flirn/strombluete/stl/kegel.stl

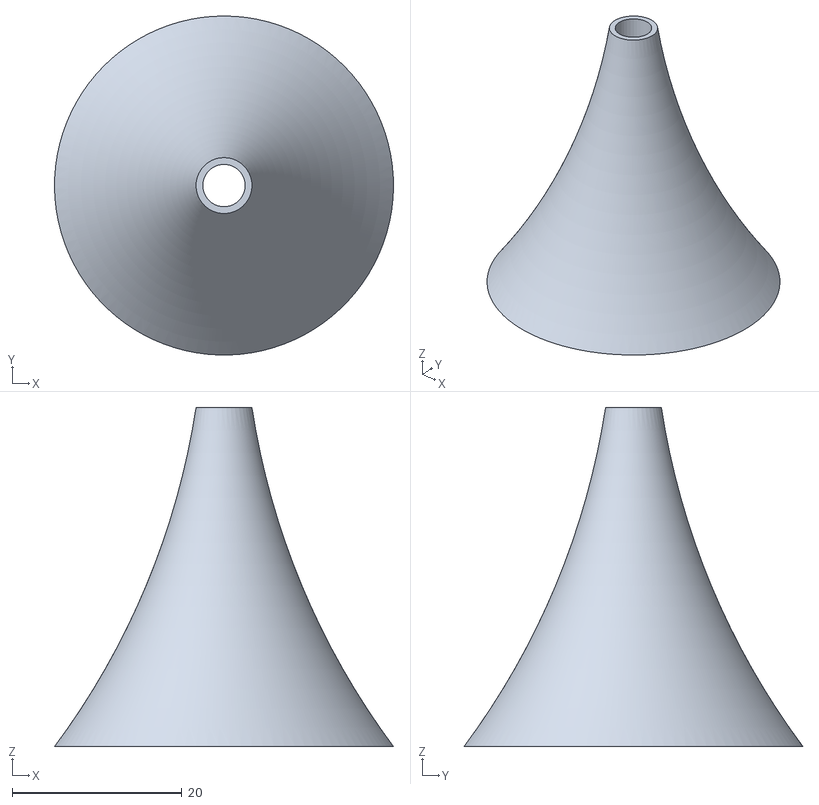
[picture p8: CAD file, 2023-10-23]
stl/kegel.stl
40.0 x 40.0 x 40.0
