flirn/strombluete/stl/kopfUnten.stl

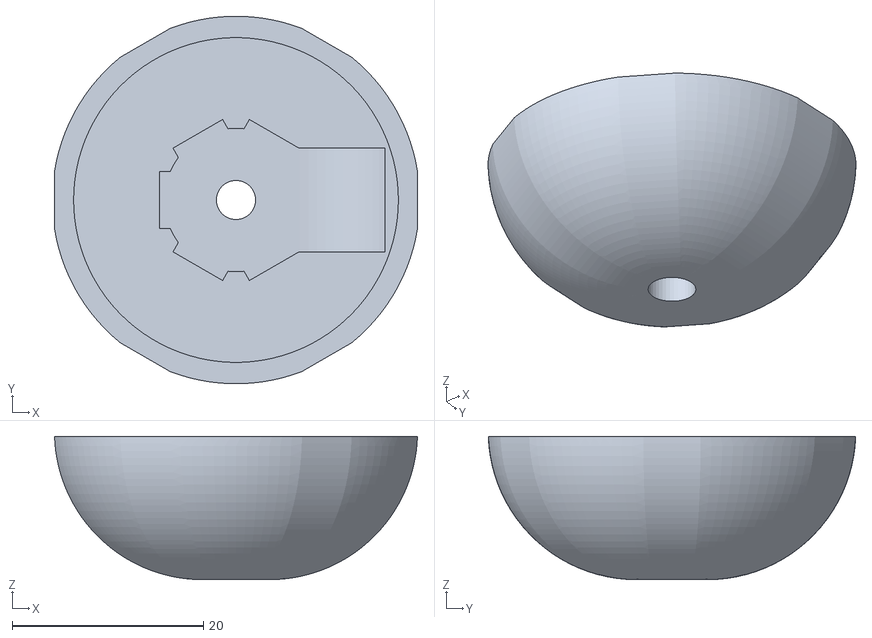
[picture p9: CAD file, 2023-10-23]
stl/kopfUnten.stl
38.0 x 38.5 x 15.0
