flirn/strombluete/stl/bluetenblatt.stl

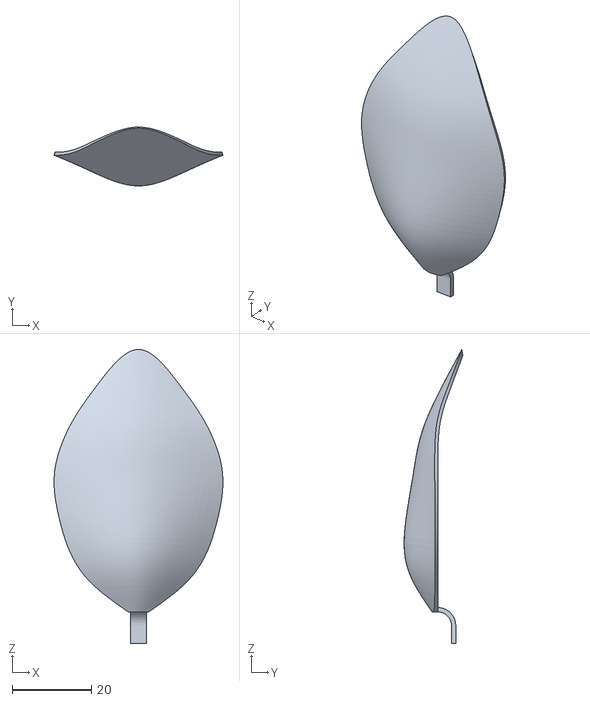
[picture p10: CAD file, 2023-10-23]
stl/bluetenblatt.stl
42.5 x 14.8 x 74.0
