flirn/strombluete/stl/kopfOben.stl

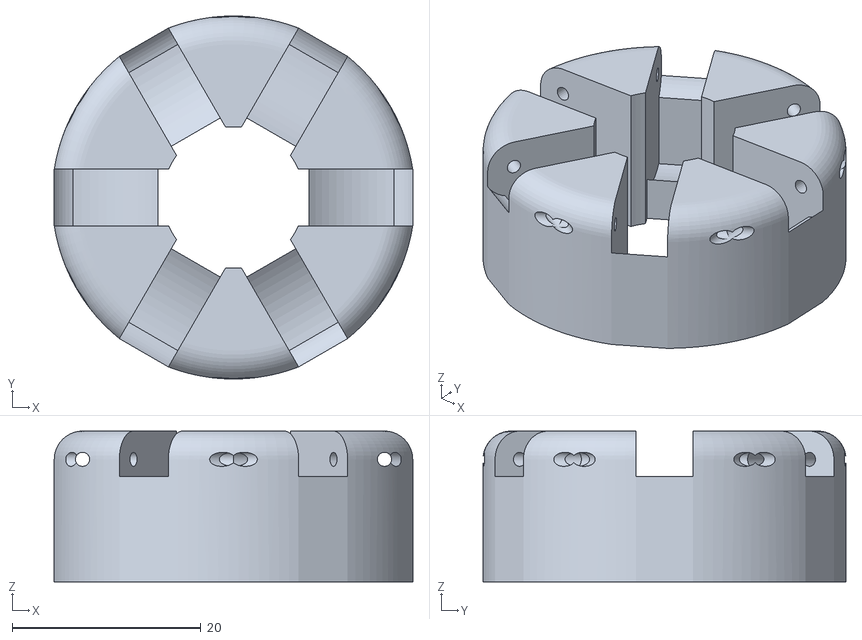
[picture p11: CAD file, 2023-10-23]
stl/kopfOben.stl
38.0 x 38.5 x 16.0
