flirn/strombluete/stl/zahnrad.stl

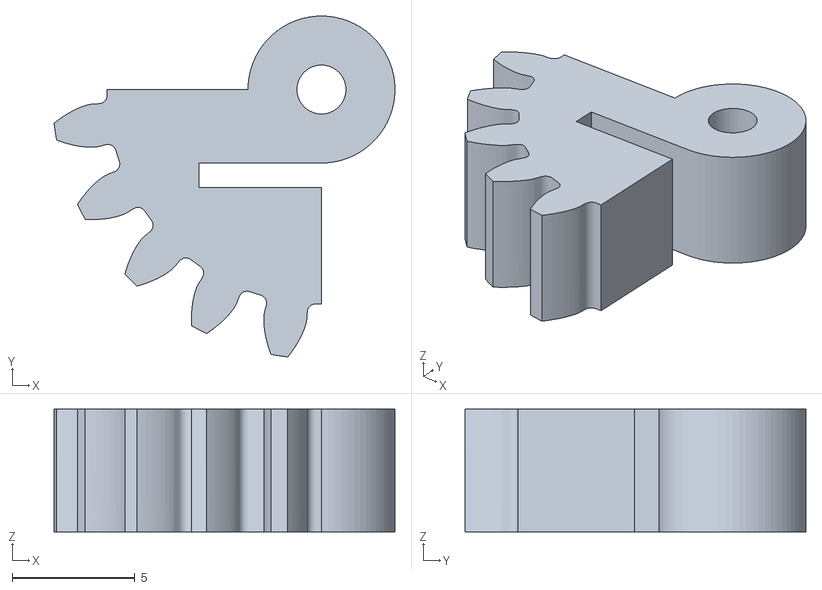
[picture p12: CAD file, 2023-10-23]
stl/zahnrad.stl
13.9 x 13.9 x 5.00
