flirn/strombluete/stl/deckel.stl

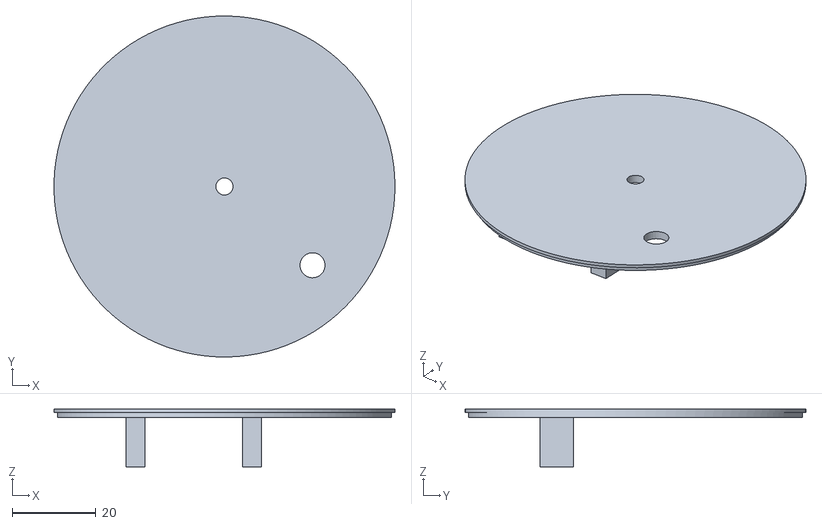
[picture p13: CAD file, 2023-10-23]
stl/deckel.stl
81.6 x 81.6 x 13.8
