flirn/strombluete/stl/basis.stl

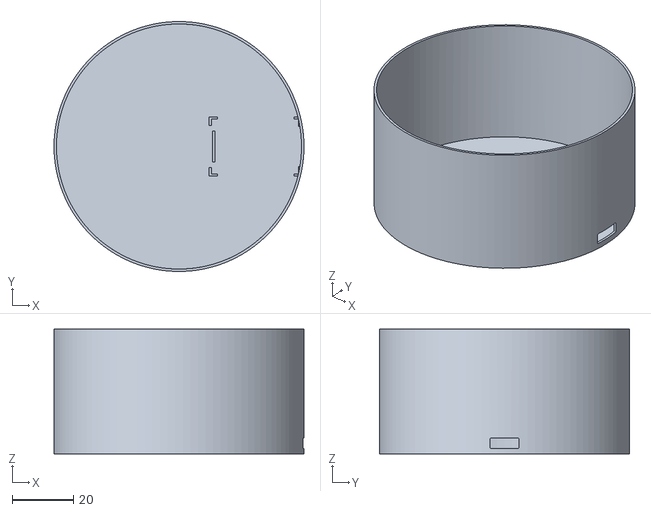
[picture p14: CAD file, 2023-10-23]
stl/basis.stl
81.6 x 81.6 x 40.8
